vitormrts/camcar/(commit log)

2023-11-17 Initial commit esp32 as Access Point
2023-12-01 Camera LilyGoCam
2023-12-07 up pins motors
